dshohat/smart-picture-frame/reference/manufacturer-dimensions.jpg

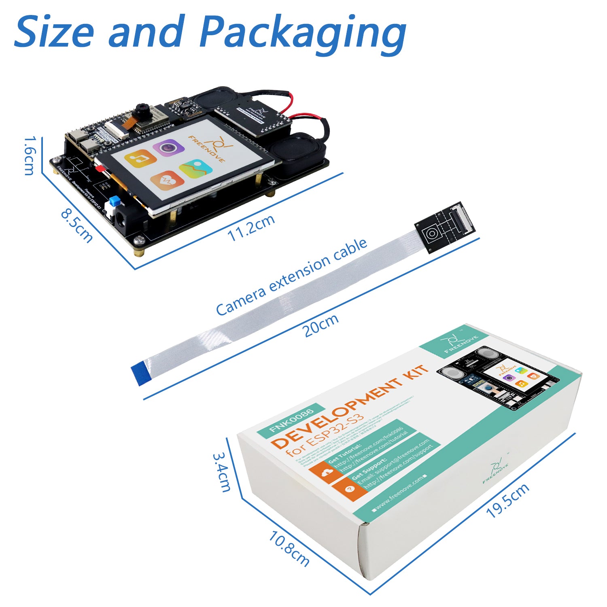
reference/manufacturer-dimensions.jpg
