dshohat/smart-picture-frame/reference/assumed-layout-overlay.jpg

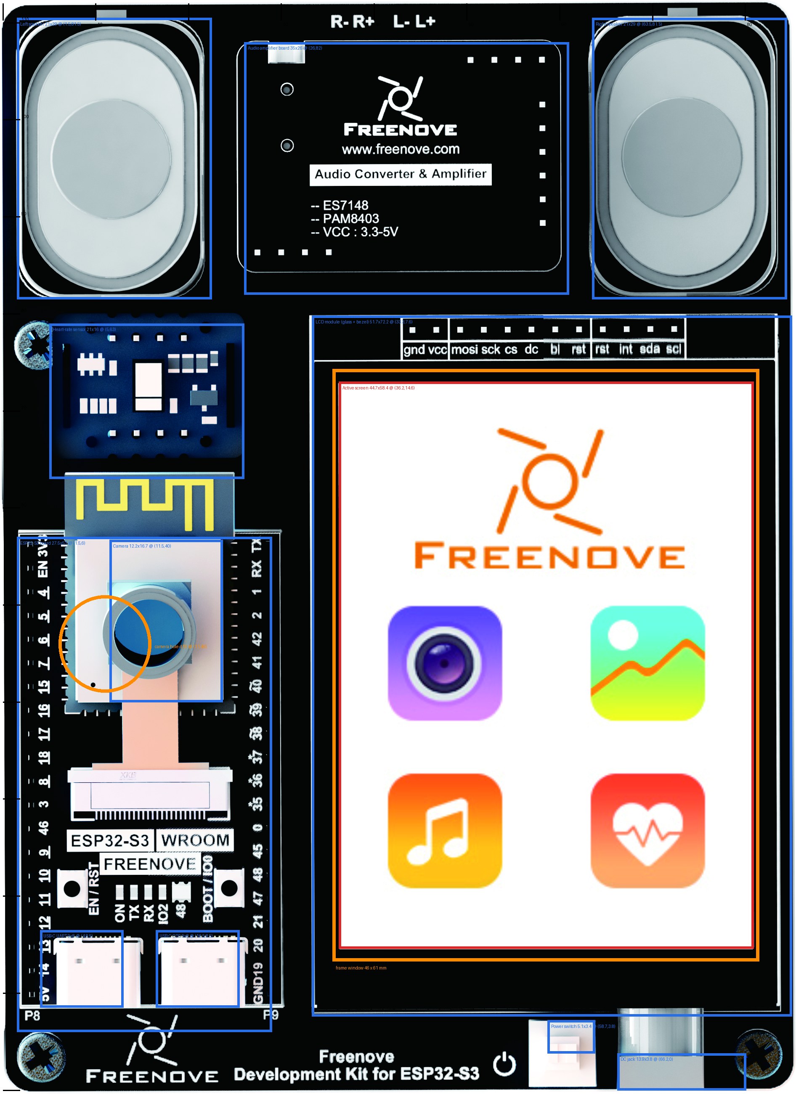
reference/assumed-layout-overlay.jpg
