dshohat/smart-picture-frame/fusion/fusion-front.png

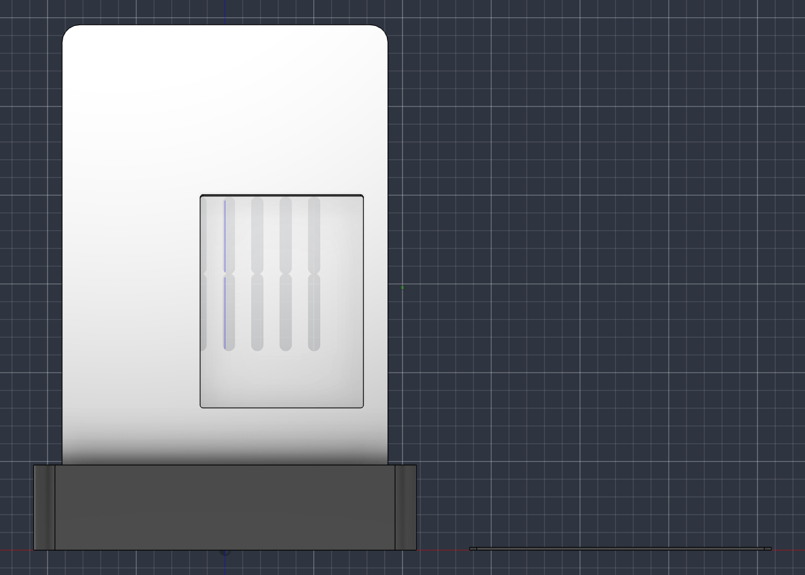
fusion/fusion-front.png
