dshohat/smart-picture-frame/fusion/fusion-view.png

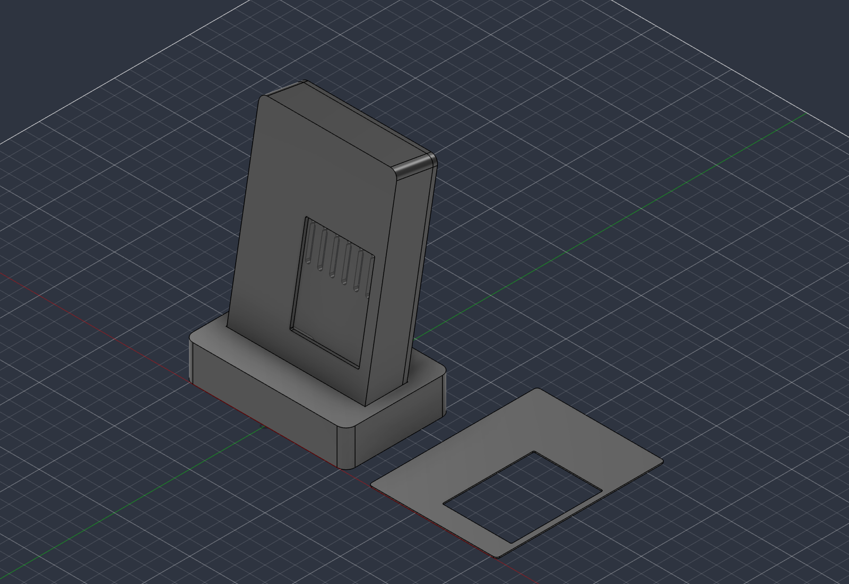
fusion/fusion-view.png
