dshohat/smart-picture-frame/fusion/smart-picture-frame.step

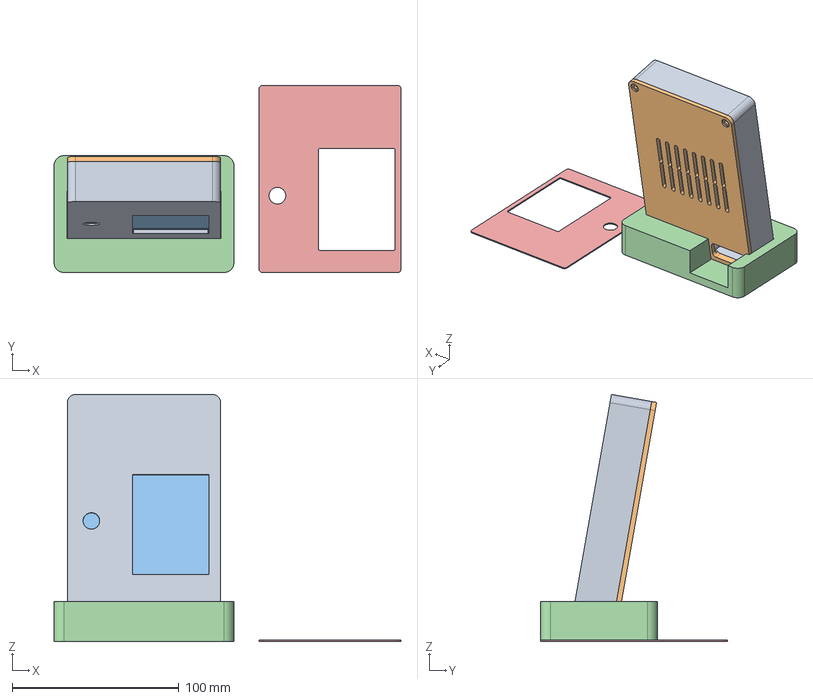
[picture p5: CAD file, 2026-10-29]
fusion/smart-picture-frame.step
207.8 x 112.0 x 148.0 mm
Front shell
Rear cover
Kit envelope (reference)
Desk stand
Alignment gauge
