dshohat/smart-picture-frame/print/front-shell.stl

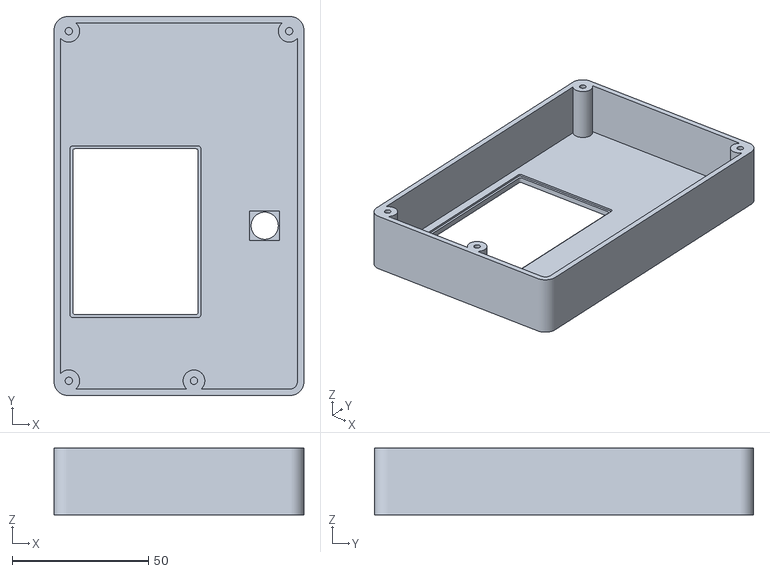
[picture p6: CAD file, 2026-10-29]
print/front-shell.stl
91.8 x 139.3 x 24.5
