dshohat/smart-picture-frame/print/alignment-gauge.stl

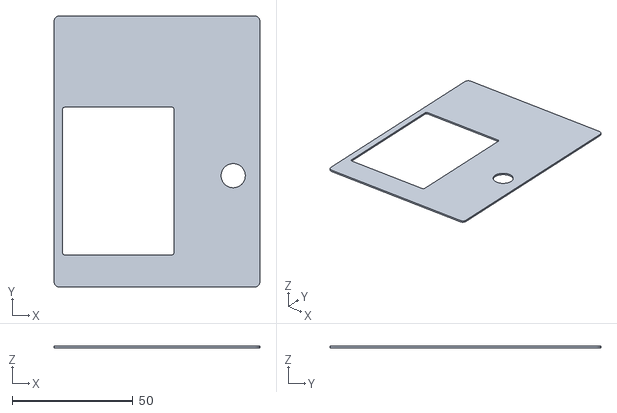
[picture p7: CAD file, 2026-10-29]
print/alignment-gauge.stl
85.0 x 112.0 x 0.8
