dshohat/smart-picture-frame/print/rear-cover.stl

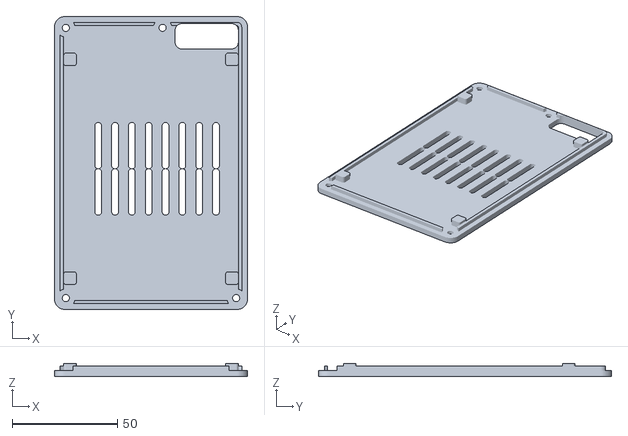
[picture p8: CAD file, 2026-10-27]
print/rear-cover.stl
91.8 x 139.3 x 6.30
