dshohat/smart-picture-frame/print/desk-stand.stl

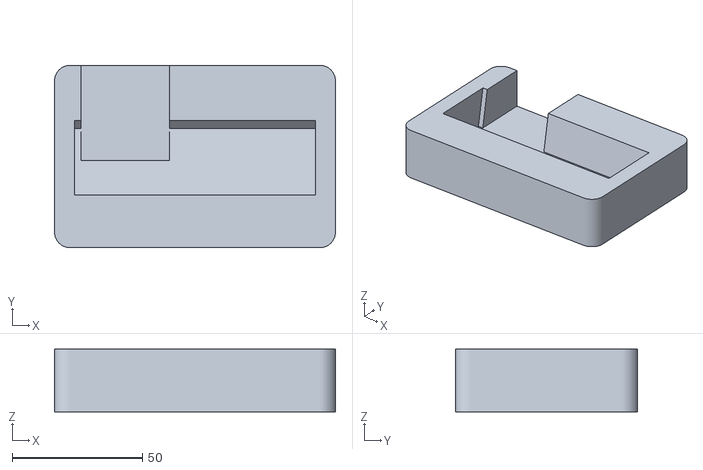
[picture p9: CAD file, 2026-10-27]
print/desk-stand.stl
107.8 x 70.0 x 24.0
