dshohat/smart-picture-frame/(list of files, cad)

Other CAD files:
fusion/smart-picture-frame.f3d
