dshohat/smart-picture-frame/reference/manufacturer-kit.jpg

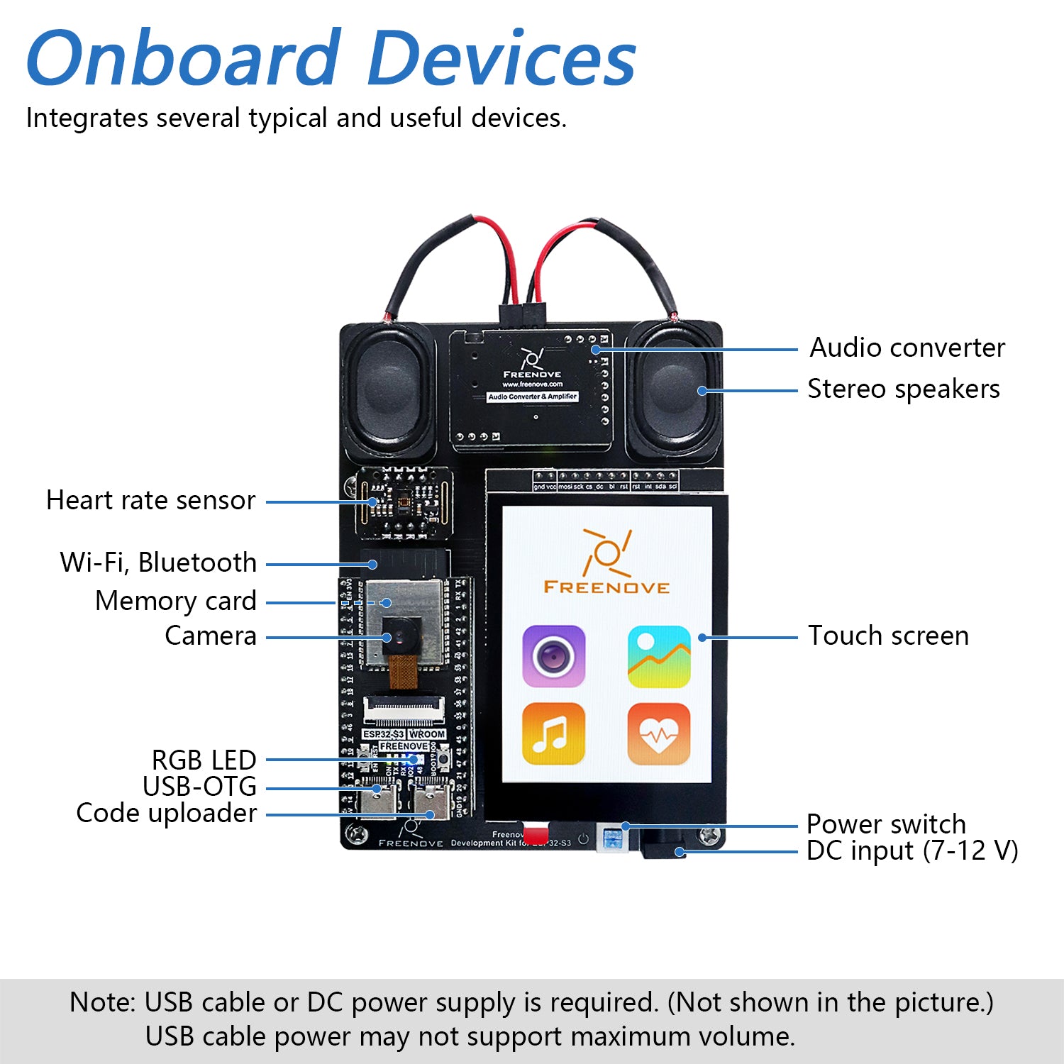
reference/manufacturer-kit.jpg
