dshohat/smart-picture-frame/(commit log)

2026-10-27 Added camera pic
2026-10-29 Moved Camera Hole
